rdubois440/cherry_mx30_usb_bt/images/20161023_181714.jpg

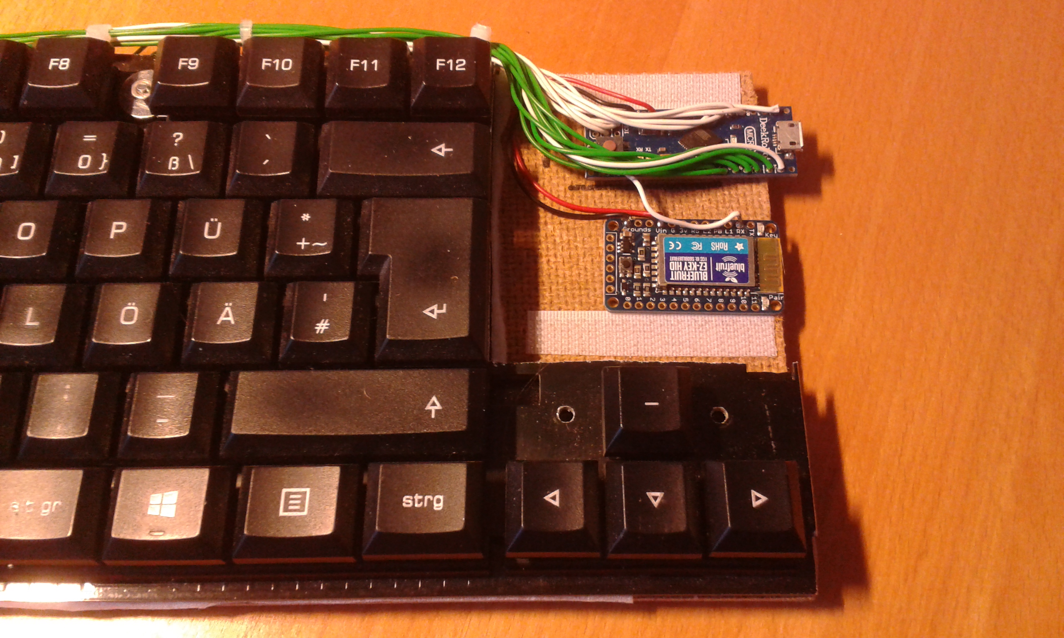
images/20161023_181714.jpg
