rdubois440/cherry_mx30_usb_bt/images/20161112_152217.jpg

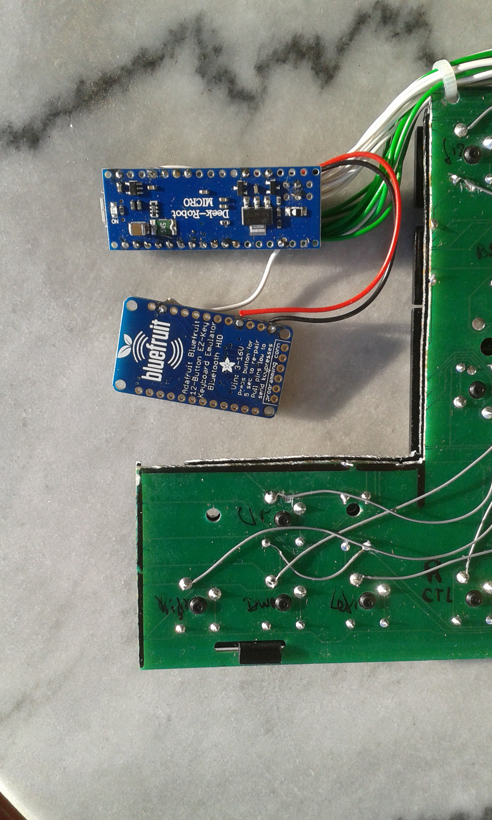
images/20161112_152217.jpg
