rdubois440/cherry_mx30_usb_bt/images/20161112_152347.jpg

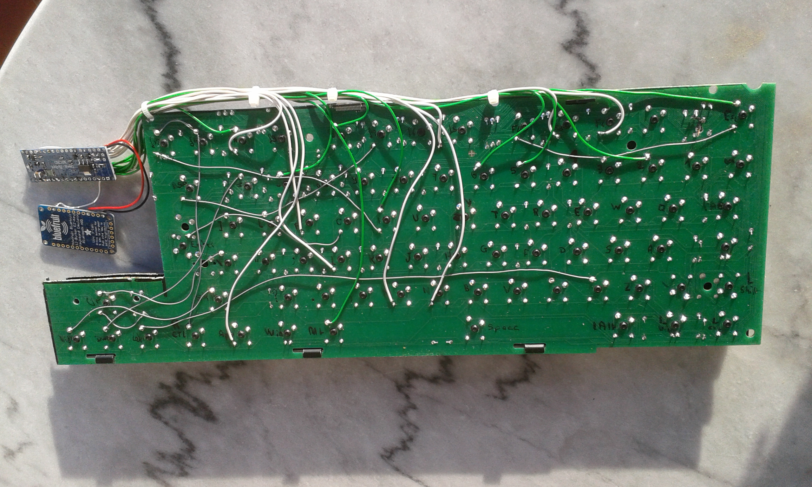
images/20161112_152347.jpg
