rdubois440/cherry_mx30_usb_bt/Cherry_Layout_20161001.ods

 | Green – Columns – Pin 1
White – Rows – Pin3 |  | D2 | D3 | D4 | D5 | D6 | D7 | D8 | D9 | D10 | D11
 | D12 | Esc | Left\ | F4 | F5 | F6 | Rshift | Lalt | G | H | “
 | D13 | ~ | F1 | F2 | F9 | = | F8 | Lctrl | 5 | 6 | -
 | D14 | Tab | CapsL | F3 | Bspace |  | F7 | Lshift | T | Y | [
 | D15 | 1 | 2 | F11 | F10 | 8 | 9 | F12 | 4 | 7 | 0
 | D16 |  | App |  |  |  |  |  |  |  | ArrUp
 | D17
 | D18 | Q | W | E | Enter |  | O |  | R | U | P
 | D19 | A | S | D |  |  | L | Rwin | f | j | ;
 | D20 | Lwin | Arr Left |  | Space | Arr Dn | ArrRght | Ralt | B | N | ?
 | D21 | Z | X | C |  |  | . | Rctrl | V | M | Right\
